tinyledmatrix/icebreaker/hardware/v1.0d_withoutSwitchPmod/icebreaker BOM.xlsx

Sheet: icebreaker
Id | Designator | Package | Quantity | Designation | MFc# | MFC | ALT-MFC# | ALT-MFC | Supplier and ref | LCSC
1 | J29,J15,J18,J16,J2,J1 | J_NC_0603_15 | 6 | Jumper
2 | U6 | QFN-48-1EP_7x7mm_Pitch0.5mm | 1 | ICE5LP4K-SG48 | ICE40UP5K-SG48I (https://octopart.com/ice40up5k-sg48i-lattice+semiconductor-87369311?r=sp&s=Q839fomTQ-WEHT9BZ4eZfQ) | Lattice |  |  |  | NA | https://octopart.com/search?q=iCE40UP5K
3 | U4 | QFN-64-4.45mm1EP_9x9mm_Pitch0.5mm | 1 | FT2232H | FT2232HQ-TRAY | FTDI |  |  |  | NA | https://octopart.com/ft2232hq-tray-ftdi-19172158?r=sp&s=PmpX5AleT3m8XSPWfIw84g
4 | C32,C34,C33 | C_0603 | 3 | DNP
5 | C15,C8,C2,C5,C9,C6,C7 | C_0603 | 7 | 4u7 |  |  |  |  |  | 0603B475K100NT (https://lcsc.com/product-detail/Multilayer-Ceramic-Capacitors-MLCC-SMD-SMT_4-7uF-475-10-10V_C108342.html)
6 | C24 | C_0603 | 1 | 10u |  |  |  |  |  | GRM188Z71A106MA73D (https://lcsc.com/product-detail/Others_Murata-Electronics-GRM188Z71A106MA73D_C237435.html)
7 | D1,D4 | D_0603 | 2 | GRN |  |  |  |  | vorhanden
8 | D3 | D_0603 | 1 | BLU |  |  |  |  | vorhanden
9 | D5 | D_0603 | 1 | RED |  |  |  |  | vorhanden
10 | R1 | R_0402 | 1 | 1M |  |  |  |  |  | RC0402FR-071ML (https://lcsc.com/product-detail/Chip-Resistor-Surface-Mount_1MR-1004-1_C138033.html)
11 | R5,R14,R15 | R_0402 | 3 | 330E |  |  |  |  |  | RC0402FR-07330RL (https://lcsc.com/product-detail/Chip-Resistor-Surface-Mount_330R-330R-1_C105875.html)
12 | R6,R12,R26 | R_0402 | 3 | 2k2 |  |  |  |  |  | RC0402FR-072K2L (https://lcsc.com/product-detail/Chip-Resistor-Surface-Mount_2-2KR-2201-1_C114762.html)
13 | R8 | R_0402 | 1 | 12k |  |  |  |  |  | RC0402FR-0712KL (https://lcsc.com/product-detail/Chip-Resistor-Surface-Mount_12KR-1202-1_C114760.html)
14 | R9,R13,R19,R3,R25 | R_0402 | 5 | 10k |  |  |  |  | wahrscheinlich vorhanden | RC0402FR-0710KL (https://lcsc.com/product-detail/Chip-Resistor-Surface-Mount_10KR-1002-1_C60490.html)
15 | R10 | R_0402 | 1 | 100E |  |  |  |  |  | RC0402FR-07100RL (https://lcsc.com/product-detail/Chip-Resistor-Surface-Mount_100R-100R-1_C106232.html)
16 | L1,L2 | L_0402 | 2 | 600 |  |  |  |  |  | SZ1005K750TF (https://lcsc.com/product-detail/Ferrite-Beads-And-Chips_75R-25-100MHz_C96985.html)
17 | C22,C21,C20,C18,C17,C14,C13,C12,C10,C16,C30,C31,C29,C27,C26,C25,C19,C1,C4,C37 | C_0402 | 20 | 100n |  |  |  |  | wahrscheinlich vorhanden | CC0402KRX7R7BB104 (https://lcsc.com/product-detail/Multilayer-Ceramic-Capacitors-MLCC-SMD-SMT_100nF-104-10-16V_C60474.html)
18 | C11,C28,C3,C38 | C_0402 | 4 | 10n |  |  |  |  |  | CC0402KRX7R7BB103 (https://lcsc.com/product-detail/Others_YAGEO-CC0402KRX7R7BB103_C327009.html)
19 | C23,C36,C39 | C_0402 | 3 | 1u |  |  |  |  |  | 0402B105K100NT (https://lcsc.com/product-detail/Multilayer-Ceramic-Capacitors-MLCC-SMD-SMT_1uF-105-10-10V_C1526.html)
20 | C35 | C_0402 | 1 | DNP
21 | U1 | SOT-23-6 | 1 | 93C46B-SOT-23-6 | 93LC46BT-E/OT | Microchip |  |  |  |  | https://octopart.com/93lc46bt-i%2Fsn-microchip-452705?r=sp&s=ogtwd_AtRJmzWBY953yhWA
22 | U2 | SOT-23-5 | 1 | 3.3V | SGM2028-3.3YN5G/TR | SGMIICRO |  |  | vorhanden (Ersatztyp) | SGM2028-3.3YN5G/TR (https://lcsc.com/product-detail/Low-Dropout-Regulators-LDO_SGM2028-3-3YN5G-TR_C81088.html)
23 | U3 | SOT-23-5 | 1 | 1V2 | SGM2019-1.2YN5G/TR | SGMICRO |  |  |  | SGM2019-1.2YN5G/TR (https://lcsc.com/product-detail/Others_SG-Micro-SGM2019-1-2YN5G-TR_C59589.html)
24 | P1 | Connector_USB_Micro_B_SMD | 1 | pkl_USB_OTG |  |  |  |  | vorhanden
25 | U5 | SOIC-8_5.3x5.3mm_Pitch1.27mm | 1 | W25Q | W25Q128JVSIQ | Winbond |  |  |  | W25Q128JVSIQ (https://lcsc.com/product-detail/FLASH_Winbond-Elec-W25Q128JVSIQ_C113767.html)
26 | U7 | SOT-23-5 | 1 | 12MHz | SIT2001BI-S2-33E-12.000000G | SiTime |  |  |  | NA
27 | P4,P3,P2,P5 | PAD_SMD_1x2.65 | 4 | UP
28 | J28 | PinHeader_2x01_P2.54mm_Vertical | 1 | CRESET |  |  |  |  | vorhanden (Ersatztyp)
29 | SW1 | SW_SPST_3x4x2.5 | 1 | TACT | SKRPABE010 | Alps |  |  |  | https://lcsc.com/product-detail/Tactile-Switches_ALPS_SKRPABE010_3-2-4-2-2-5-1-57N_C115360.html
30 | P6 | PAD_SMD_1x1.5 | 1 | RAM_CS
31 | J13,J11,J9,J8,J7,J6,J5,J4,J3,J10,J12 | J_0603 | 11 | Jumper
32 | J14,J19 | J_NC_0603_30 | 2 | Jumper
33 | J17,J30 | J_NCNO_0903_30 | 2 | Jumper
34 | D2 | D_SOD-523 | 1 | ~~800mVf | CDBU0520 ??? |  |  |  | wahrscheinlich vorhanden
35 | R11,R2 | R_Array_Convex_4x0402 | 2 | 10k | YC124-FR-0710KL | Yageo |  |  |  | YC124-FR-0710KL (https://lcsc.com/product-detail/Resistor-Networks-Arrays_10KR-1002-1_C136853.html)
36 | R20,R4,R21,R22,R24,R23 | R_Array_Convex_4x0402 | 6 | 33E | YC124-FR-0710KL | Yageo |  |  |  | YC124-FR-0733RL (https://lcsc.com/product-detail/Resistor-Networks-Arrays_33R-33R0-1_C136851.html)
37 | D11 | LED_Cree_PLCC6_3.4x3.4mm | 1 | LED_RGB | FM-Z3535RGBA-SH | Foshan NationStar Optoelectronics | LTSN-D353EGBW | Lite-On |  | FM-Z3535RGBA-SH (https://lcsc.com/product-detail/Light-Emitting-Diodes-LED_SMDLED-120-480mcd_C110903.html)
38 | REF**,REF**,REF**,REF** | MountingHole_3-5mm | 4 | MH3
39 | J20 | Pin_Header_Straight_1x07 | 1 | Flash
40 | J25 | Pin_Header_Straight_2x04 | 1 | RGB Led
41 | J27,J26 | Pin_Header_Straight_2x01 | 2 | 5V AUX
42 | J23 | Socket_Strip_Straight_2x06 | 1 | PMOD |  |  |  |  | vorhanden (Ersatztyp) |  | zu Pos 43 ergänst -> alle P-mods gleich
43 | J22,J21, J23 | Socket_Strip_Angled_2x06 | 2 | PMOD |  |  |  |  |  | A2541HWR-2x6P (https://lcsc.com/product-detail/Pin-Header-Female-Header_Changjiang-Connectors-A2541HWR-2x6P_C239357.html)
 |  |  | v

Sheet: Tabelle1
1 | ICE40UP5K-SG48I (https://octopart.com/ice40up5k-sg48i-lattice+semiconductor-87369311?r=sp&s=Q839fomTQ-WEHT9BZ4eZfQ)
1 | FT2232HQ-TRAY
1 | 93LC46BT-I/SN
1 | SGM2028-3.3YN5G/TR
1 | SGM2019-1.2YN5G/TR
1 | W25Q128JVSIQ
1 | SIT2001BI-S2-33E-12.000000G
1 | SKRPABE010
2 | YC124-FR-0710KL
6 | YC124-FR-0710KL
1 | FM-Z3535RGBA-SH
