tinyledmatrix/icebreaker/hardware/v1.0d_withoutSwitchPmod/icebreaker-sch.pdf

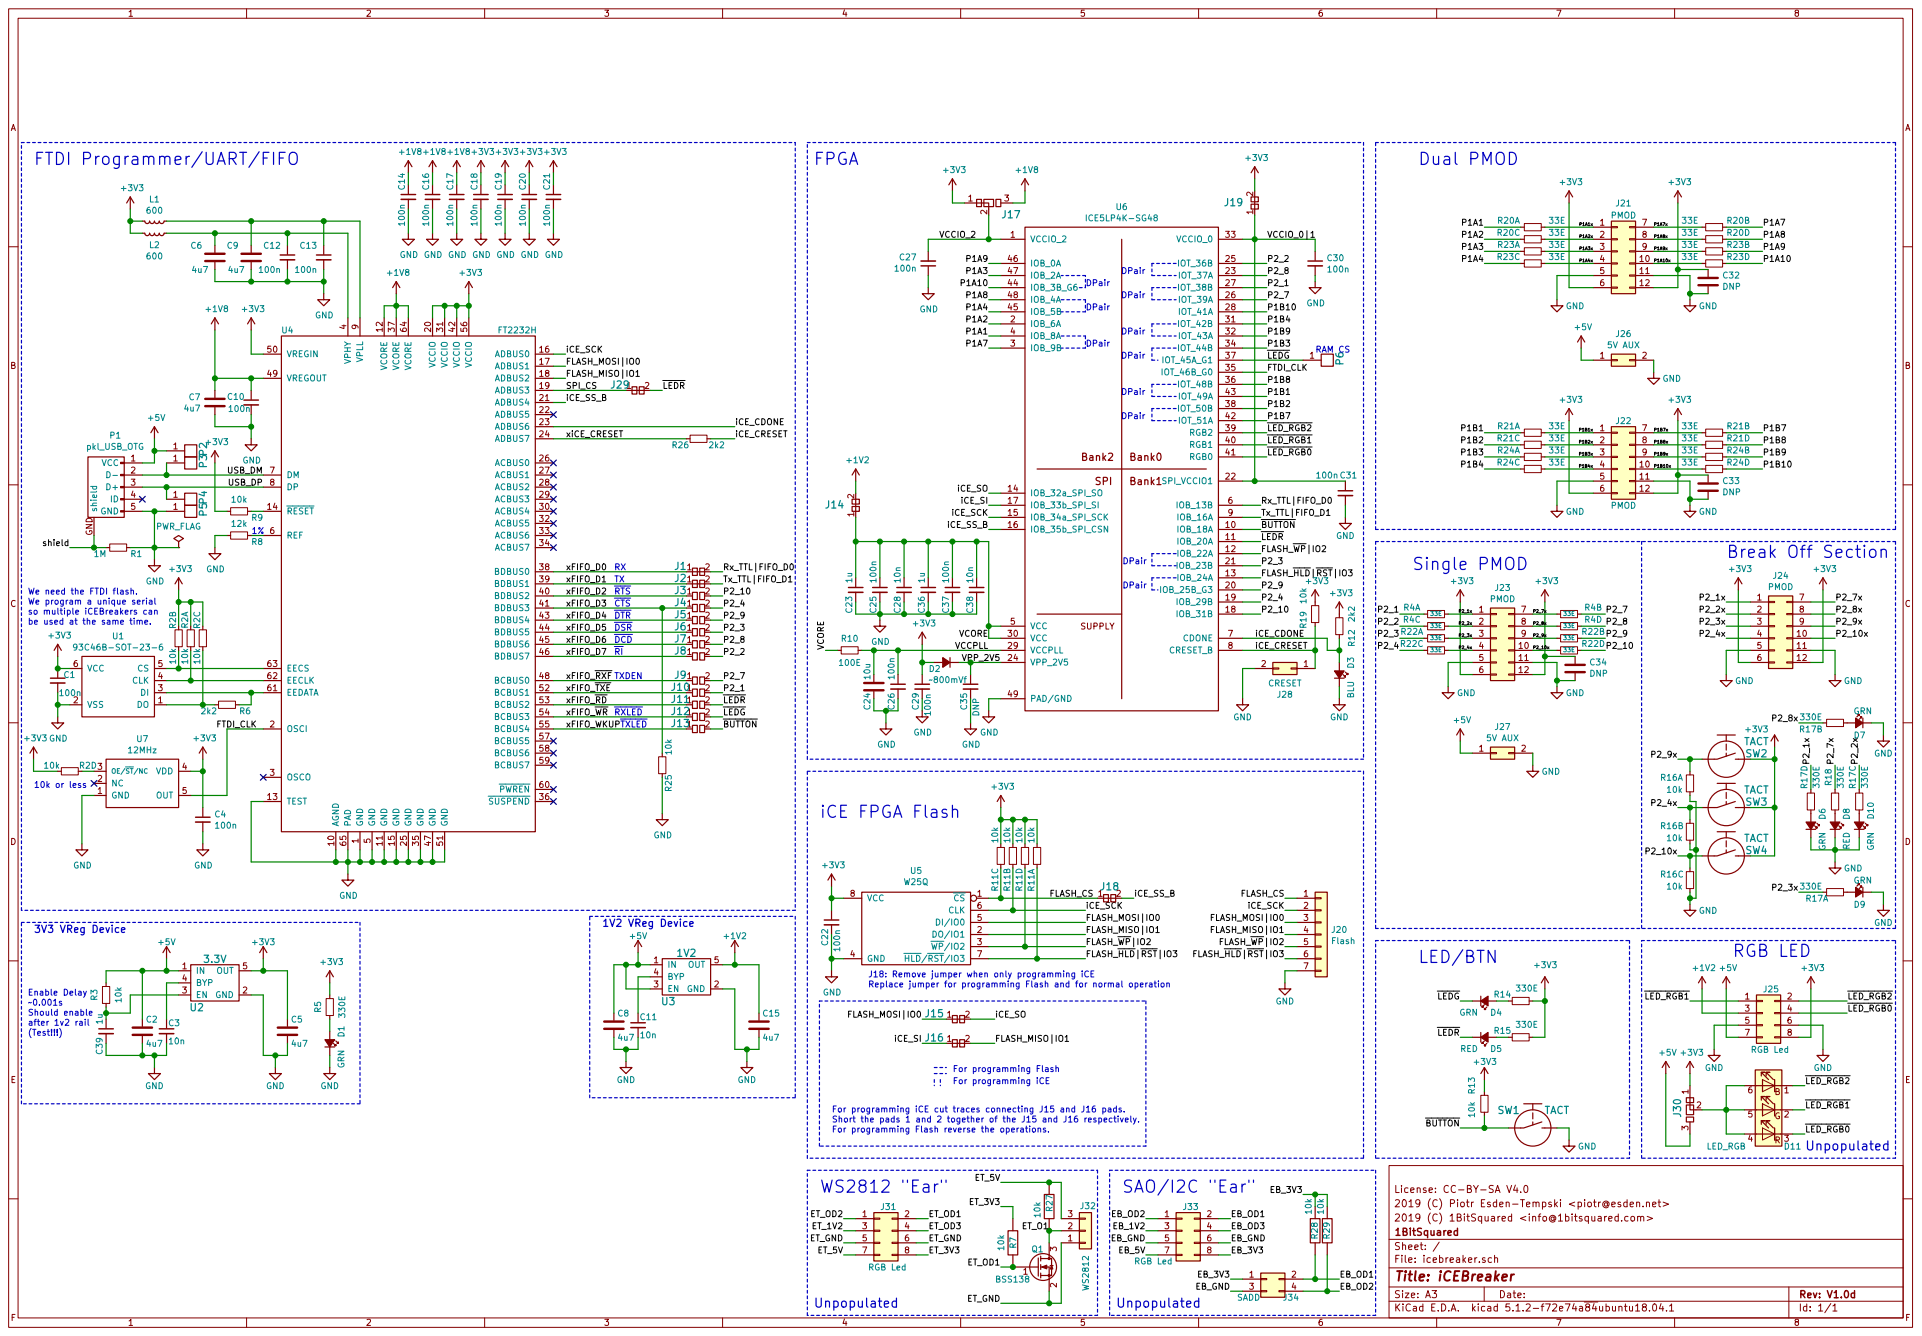
[picture p1: page 1]

LED_RGB2 FTDI Programmer/UART/FIFO

1 AGND 10 GND 11 VCORE 12 TEST 13 RESET 14 GND 15 ADBUS0 16 ADBUS1 17 ADBUS2 18 ADBUS3 19 OSCI 2 VCCIO 20 ADBUS4 21 ADBUS5 22 ADBUS6 23 ADBUS7 24 GND 25 ACBUS0 26 ACBUS1 27 ACBUS2 28 ACBUS3 29 OSCO 3 ACBUS4 30 VCCIO 31 ACBUS5 32 ACBUS6 33 ACBUS7 34 GND 35 SUSPEND 36 VCORE 37 BDBUS0 38 BDBUS1 39 VPHY

4 BDBUS2 40 BDBUS3 41 VCCIO 42 BDBUS4 43 BDBUS5 44 BDBUS6 45 BDBUS7 46 GND 47 BCBUS0 48 VREGOUT 49 GND

5 VREGIN 50 GND 51 BCBUS1 52 BCBUS2 53 BCBUS3 54 BCBUS4 55 VCCIO 56 BCBUS5 57 BCBUS6 58 BCBUS7 59 REF 6 PWREN 60 EEDATA 61 EECLK 62 EECS 63 VCORE 64 PAD 65 DM 7 DP 8 VPLL

4 | 10

800mVf VPP_2V5 We need the FTDI flash. We program a unique serial

so multiple iCEBreakers can
be used at the same time.
93C46B-SOT-23-6 +3V3 GND

J18: Remove jumper when only programming iCE

Enable Delay 0.001s Should enable

For programming iCE cut traces connecting J15 and J16 pads.
Short the pads 1 and 2 together of the J15 and J16 respectively.
For programming Flash reverse the operations.

License: CC-BY-SA V4.0
2019 (C) Piotr Esden-Tempski <piotr@esden.net>
2019 (C) 1BitSquared <info@1bitsquared.com>
Id: 1/1 Title: iCEBreaker File: icebreaker.sch Sheet: / 1BitSquared
