tinyledmatrix/icebreaker/hardware/v1.0d_withoutSwitchPmod/icebreaker.kicad_pcb

## KiCad design hardware/v1.0d_withoutSwitchPmod/icebreaker.kicad_pcb (2019-06-27)

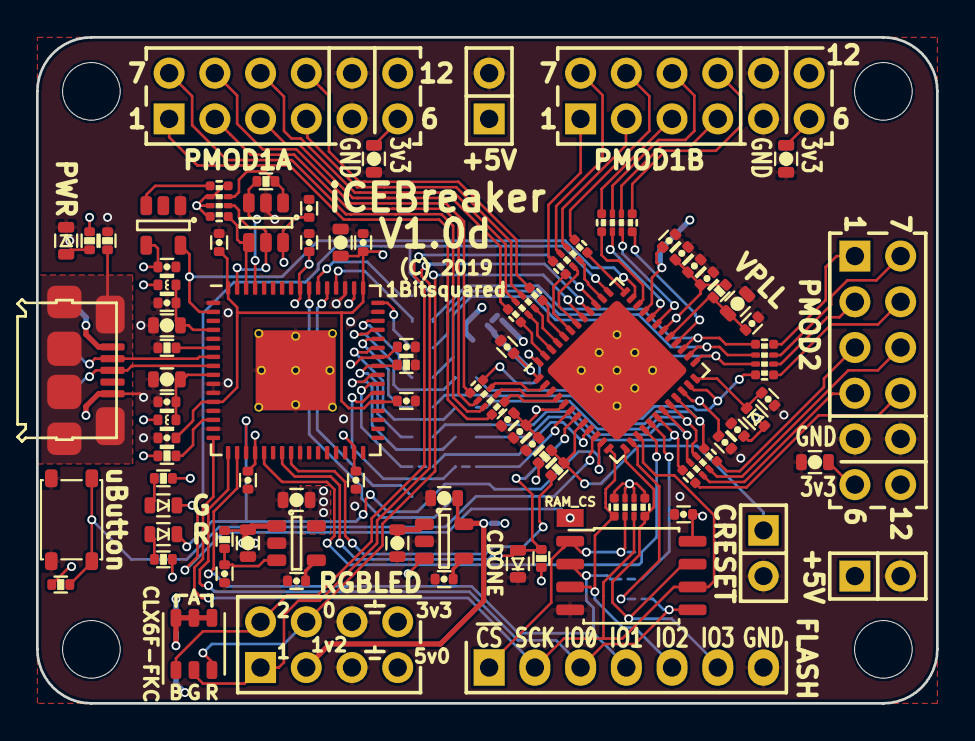
[picture p2: board icebreaker.kicad_pcb from above]

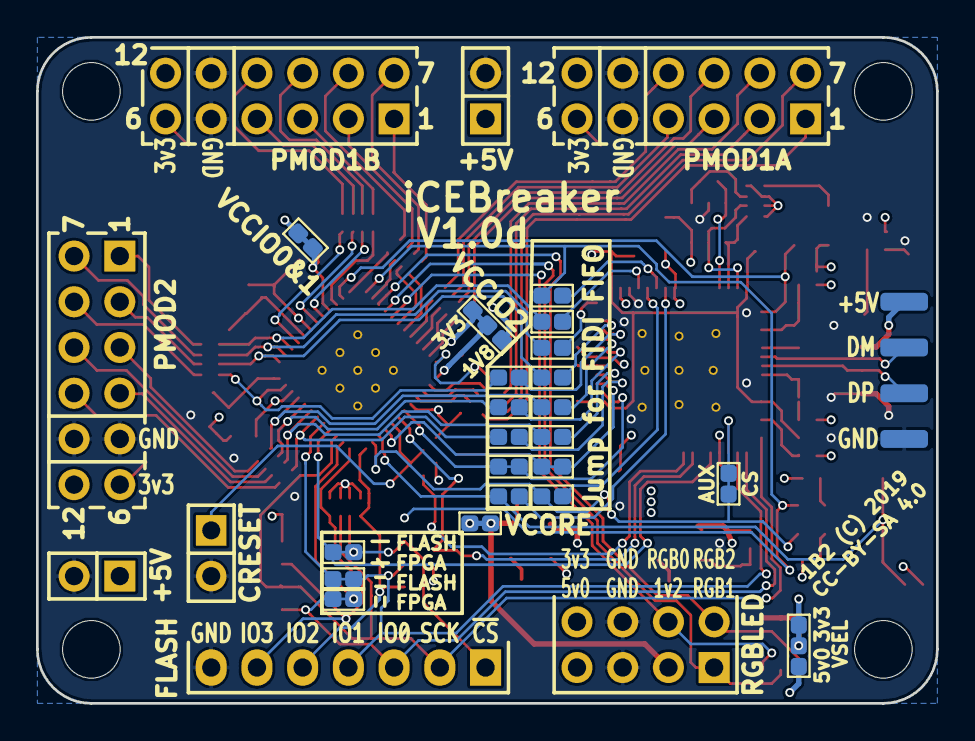
[picture p3: board icebreaker.kicad_pcb from below]

Board: 4 copper layers, 50.0 x 37.0 mm, 112 parts (25 on the bottom side), 112 nets.

Parts:
C1, C4, C10, C12, C13, C14, C16, C17, C18, C19, C20, C21, C22, C25, C26, C27, C29, C30, C31, C37: 100n; C_0402
C2, C5, C6, C7, C8, C9, C15: 4u7; C_0603
C3, C11, C28, C38: 10n; C_0402
C23, C36, C39: 1u; C_0402
C24: 10u; C_0603
C32, C33, C34: DNP; C_0603
C35: DNP; C_0402
D1, D4: GRN; D_0603
D2: ~~800mVf; D_SOD-523
D3: BLU; D_0603
D5: RED; D_0603
D11: LED_RGB; LED_Cree_PLCC6_3.4x3.4mm
J1, J2, J15, J16, J18, J29: Jumper; J_NC_0603_15
J3, J4, J5, J6, J7, J8, J9, J10, J11, J12, J13: Jumper; J_0603
J14, J19: Jumper; J_NC_0603_30
J17, J30: Jumper; J_NCNO_0903_30
J20: Flash; Pin_Header_Straight_1x07
J21, J22: PMOD; Socket_Strip_Angled_2x06
J23: PMOD; Socket_Strip_Straight_2x06
J25: RGB Led; Pin_Header_Straight_2x04
J26, J27: 5V AUX; Pin_Header_Straight_2x01
J28: CRESET; PinHeader_2x01_P2.54mm_Vertical
L1, L2: 600; L_0402
P1: pkl_USB_OTG; Connector_USB_Micro_B_SMD
P2, P3, P4, P5: UP; PAD_SMD_1x2.65
P6: RAM_CS; PAD_SMD_1x1.5
R1: 1M; R_0402
R2, R11: 10k; R_Array_Convex_4x0402
R3, R9, R13, R19, R25: 10k; R_0402
R4, R20, R21, R22, R23, R24: 33E; R_Array_Convex_4x0402
R5, R14, R15: 330E; R_0402
R6, R12, R26: 2k2; R_0402
R8: 12k; R_0402
R10: 100E; R_0402
SW1: TACT; SW_SPST_3x4x2.5
U1: 93C46B-SOT-23-6; SOT-23-6
U2: 3.3V; SOT-23-5
U3: 1V2; SOT-23-5
U4: FT2232H; QFN-64-4.45mm1EP_9x9mm_Pitch0.5mm
U5: W25Q; SOIC-8_5.3x5.3mm_Pitch1.27mm
U6: ICE5LP4K-SG48; QFN-48-1EP_7x7mm_Pitch0.5mm
U7: 12MHz; SOT-23-5

Connections:
+1V2: C15.1, J14.2, J25.3, U3.5
+1V8: C7.1, C10.1, C14.1, C16.1, C17.1, J17.3, U4.12, U4.37, U4.49, U4.64
+3V3: C1.1, C4.1, C5.1, C18.1, C19.1, C20.1, C21.1, C22.1, C29.1, C32.2, C33.2, C34.2, D2.A, J17.1, J19.2, J21.6, J21.12, J22.6, J22.12, J23.6, J23.12, J25.8, J30.1, L1.1, L2.1, R2.2, R2.4, R2.6, R2.7, R5.1, R9.2, R11.1, R11.3, R11.5, R11.7, R12.1, R13.2, R14.2, R15.2, R19.1, U1.6, U2.5, U4.20, U4.31, U4.42, U4.50, U4.56, U5.8, U7.4
+5V: C2.1, C8.1, J25.7, J26.1, J27.1, J30.3, P1.1, P2.1, R3.1, U2.1, U3.1, U3.3
/FLASH_CS: J18.1, J20.1, R11.6, U5.1
/FLASH_MISO|IO1: J16.2, J20.4, U4.18, U5.2
/FLASH_MOSI|IO0: J15.1, J20.3, U4.17, U5.5
/FLASH_~HLD~|~RST~|IO3: J20.6, R11.2, U5.7, U6.13
/FLASH_~WP~|IO2: J20.5, R11.8, U5.3, U6.12
/FTDI_CLK: U4.2, U6.35, U7.5
/P1A1: R20.1, U6.4
/P1A1x: J21.1, R20.2
/P1A2: R20.5, U6.2
/P1A2x: J21.2, R20.6
/P1A3: R23.1, U6.47
/P1A3x: J21.3, R23.2
/P1A4: R23.5, U6.45
/P1A4x: J21.4, R23.6
/P1A7: R20.3, U6.3
/P1A7x: J21.7, R20.4
/P1A8: R20.7, U6.48
/P1A8x: J21.8, R20.8
/P1A9: R23.3, U6.46
/P1A9x: J21.9, R23.4
/P1A10: R23.7, U6.44
/P1A10x: J21.10, R23.8
/P1B1: R21.1, U6.43
/P1B1x: J22.1, R21.2
/P1B2: R21.5, U6.38
/P1B2x: J22.2, R21.6
/P1B3: R24.1, U6.34
/P1B3x: J22.3, R24.2
/P1B4: R24.5, U6.31
/P1B4x: J22.4, R24.6
/P1B7: R21.3, U6.42
/P1B7x: J22.7, R21.4
/P1B8: R21.7, U6.36
/P1B8x: J22.8, R21.8
/P1B9: R24.3, U6.32
/P1B9x: J22.9, R24.4
/P1B10: R24.7, U6.28
/P1B10x: J22.10, R24.8
/P2_1: J10.2, R4.1, U6.27
/P2_1x: J23.1, R4.2
/P2_2: J8.2, R4.5, U6.25
/P2_2x: J23.2, R4.6
/P2_3: J6.2, R22.1, U6.21
/P2_3x: J23.3, R22.2
/P2_4: J4.2, R22.5, U6.19
/P2_4x: J23.4, R22.6
/P2_7: J9.2, R4.3, U6.26
/P2_7x: J23.7, R4.4
/P2_8: J7.2, R4.7, U6.23
/P2_8x: J23.8, R4.8
/P2_9: J5.2, R22.3, U6.20
/P2_9x: J23.9, R22.4
/P2_10: J3.2, R22.7, U6.18
/P2_10x: J23.10, R22.8
/Rx_TTL|FIFO_D0: J1.2, U6.6
/SPI_CS: J29.1, U4.19
/Tx_TTL|FIFO_D1: J2.2, U6.9
/USB_DM: P1.2, P3.1, U4.7
/USB_DP: P1.3, P4.1, U4.8
/VCCIO_0|1: C30.1, C31.1, J19.1, U6.22, U6.33
/VCCIO_2: C27.2, J17.2, U6.1
/VCCPLL: C24.1, C26.1, R10.1, U6.29
/VCORE: C23.1, C25.1, C28.1, C36.1, C37.1, C38.1, J14.1, R10.2, U6.5, U6.30
/VPP_2V5: C35.1, D2.C, U6.24
/iCE_CDONE: D3.A, R12.2, U4.23, U6.7
/iCE_CRESET: J28.1, R19.2, R26.1, U6.8
/iCE_SCK: J20.2, R11.4, U4.16, U5.6, U6.15
/iCE_SI: J16.1, U6.17
/iCE_SO: J15.2, U6.14
/iCE_SS_B: J18.2, U4.21, U6.16
/shield: P1.GND, R1.2
/xFIFO_D0: J1.1, U4.38
/xFIFO_D1: J2.1, U4.39
/xFIFO_D2: J3.1, U4.40
/xFIFO_D3: J4.1, R25.1, U4.41
/xFIFO_D4: J5.1, U4.43
/xFIFO_D5: J6.1, U4.44
/xFIFO_D6: J7.1, U4.45
/xFIFO_D7: J8.1, U4.46
/xFIFO_WKUP: J13.1, U4.55
/xFIFO_~RD: J11.1, U4.53
/xFIFO_~RXF: J9.1, U4.48
/xFIFO_~TXE: J10.1, U4.52
/xFIFO_~WR: J12.1, U4.54
/xiCE_CRESET: R26.2, U4.24
/~BUTTON: J13.2, R13.1, SW1.1, U6.10
/~LEDG: D4.C, J12.2, P6.1, U6.37
/~LEDR: D5.C, J11.2, J29.2, U6.11
/~LED_RGB0: D11.3, J25.4, U6.41
/~LED_RGB1: D11.2, J25.1, U6.40
/~LED_RGB2: D11.1, J25.2, U6.39
GND: C1.2, C2.2, C3.2, C4.2, C5.2, C6.2, C7.2, C8.2, C9.2, C10.2, C11.2, C12.2, C13.2, C14.2, C15.2, C16.2, C17.2, C18.2, C19.2, C20.2, C21.2, C22.2, C23.2, C24.2, C25.2, C26.2, C27.1, C28.2, C29.2, C30.2, C31.2, C32.1, C33.1, C34.1, C35.2, C36.2, C37.2, C38.2, C39.2, D1.C, D3.C, J20.7, J21.5, J21.11, J22.5, J22.11, J23.5, J23.11, J25.5, J25.6, J26.2, J27.2, J28.2, P1.5, P5.1, R1.1, R8.2, R25.2, SW1.2, U1.2, U2.2, U3.2, U4.1, U4.5, U4.10, U4.11, U4.13, U4.15, U4.25, U4.35, U4.47, U4.51, U4.65, U5.4, U6.49, U7.1
unnamed: C3.1, U2.4
unnamed: C11.1, U3.4
unnamed: C6.1, C12.1, L2.2, U4.4
unnamed: C9.1, C13.1, L1.2, U4.9
unnamed: C39.1, R3.2, U2.3
unnamed: D1.A, R5.2
unnamed: D4.A, R14.1
unnamed: D5.A, R15.1
unnamed: D11.4, D11.5, D11.6, J30.2
unnamed: R2.1, U1.4, U4.62
unnamed: R2.3, U1.5, U4.63
unnamed: R2.5, R6.2, U1.1
unnamed: R2.8, U7.3
unnamed: R6.1, U1.3, U4.61
unnamed: R8.1, U4.6
unnamed: R9.1, U4.14
