tinyledmatrix/icebreaker/(notices)

Notices in the files:
hardware/v1.0d_withoutSwitchPmod/icebreaker.kicad_pcb:
(C) 2019 Piotr Esden-Tempski
(C) 2019 1BitSquared
License: CC-BY-SA 4.0
1B2 (C) 2019
CC-BY-SA 4.0
(C) 2019
